sherwin-sattar/ESP32_V1.1/README.md

# ESP32 V1.1 (USB C)
## 3D views
ESP32 V1 1(1)
ESP32 V1 1(2)
