sherwin-sattar/ESP32_V1.1/Hardware/ESP32 V1.1.kicad_pcb

## KiCad design Hardware/ESP32 V1.1.kicad_pcb (2024-11-20)

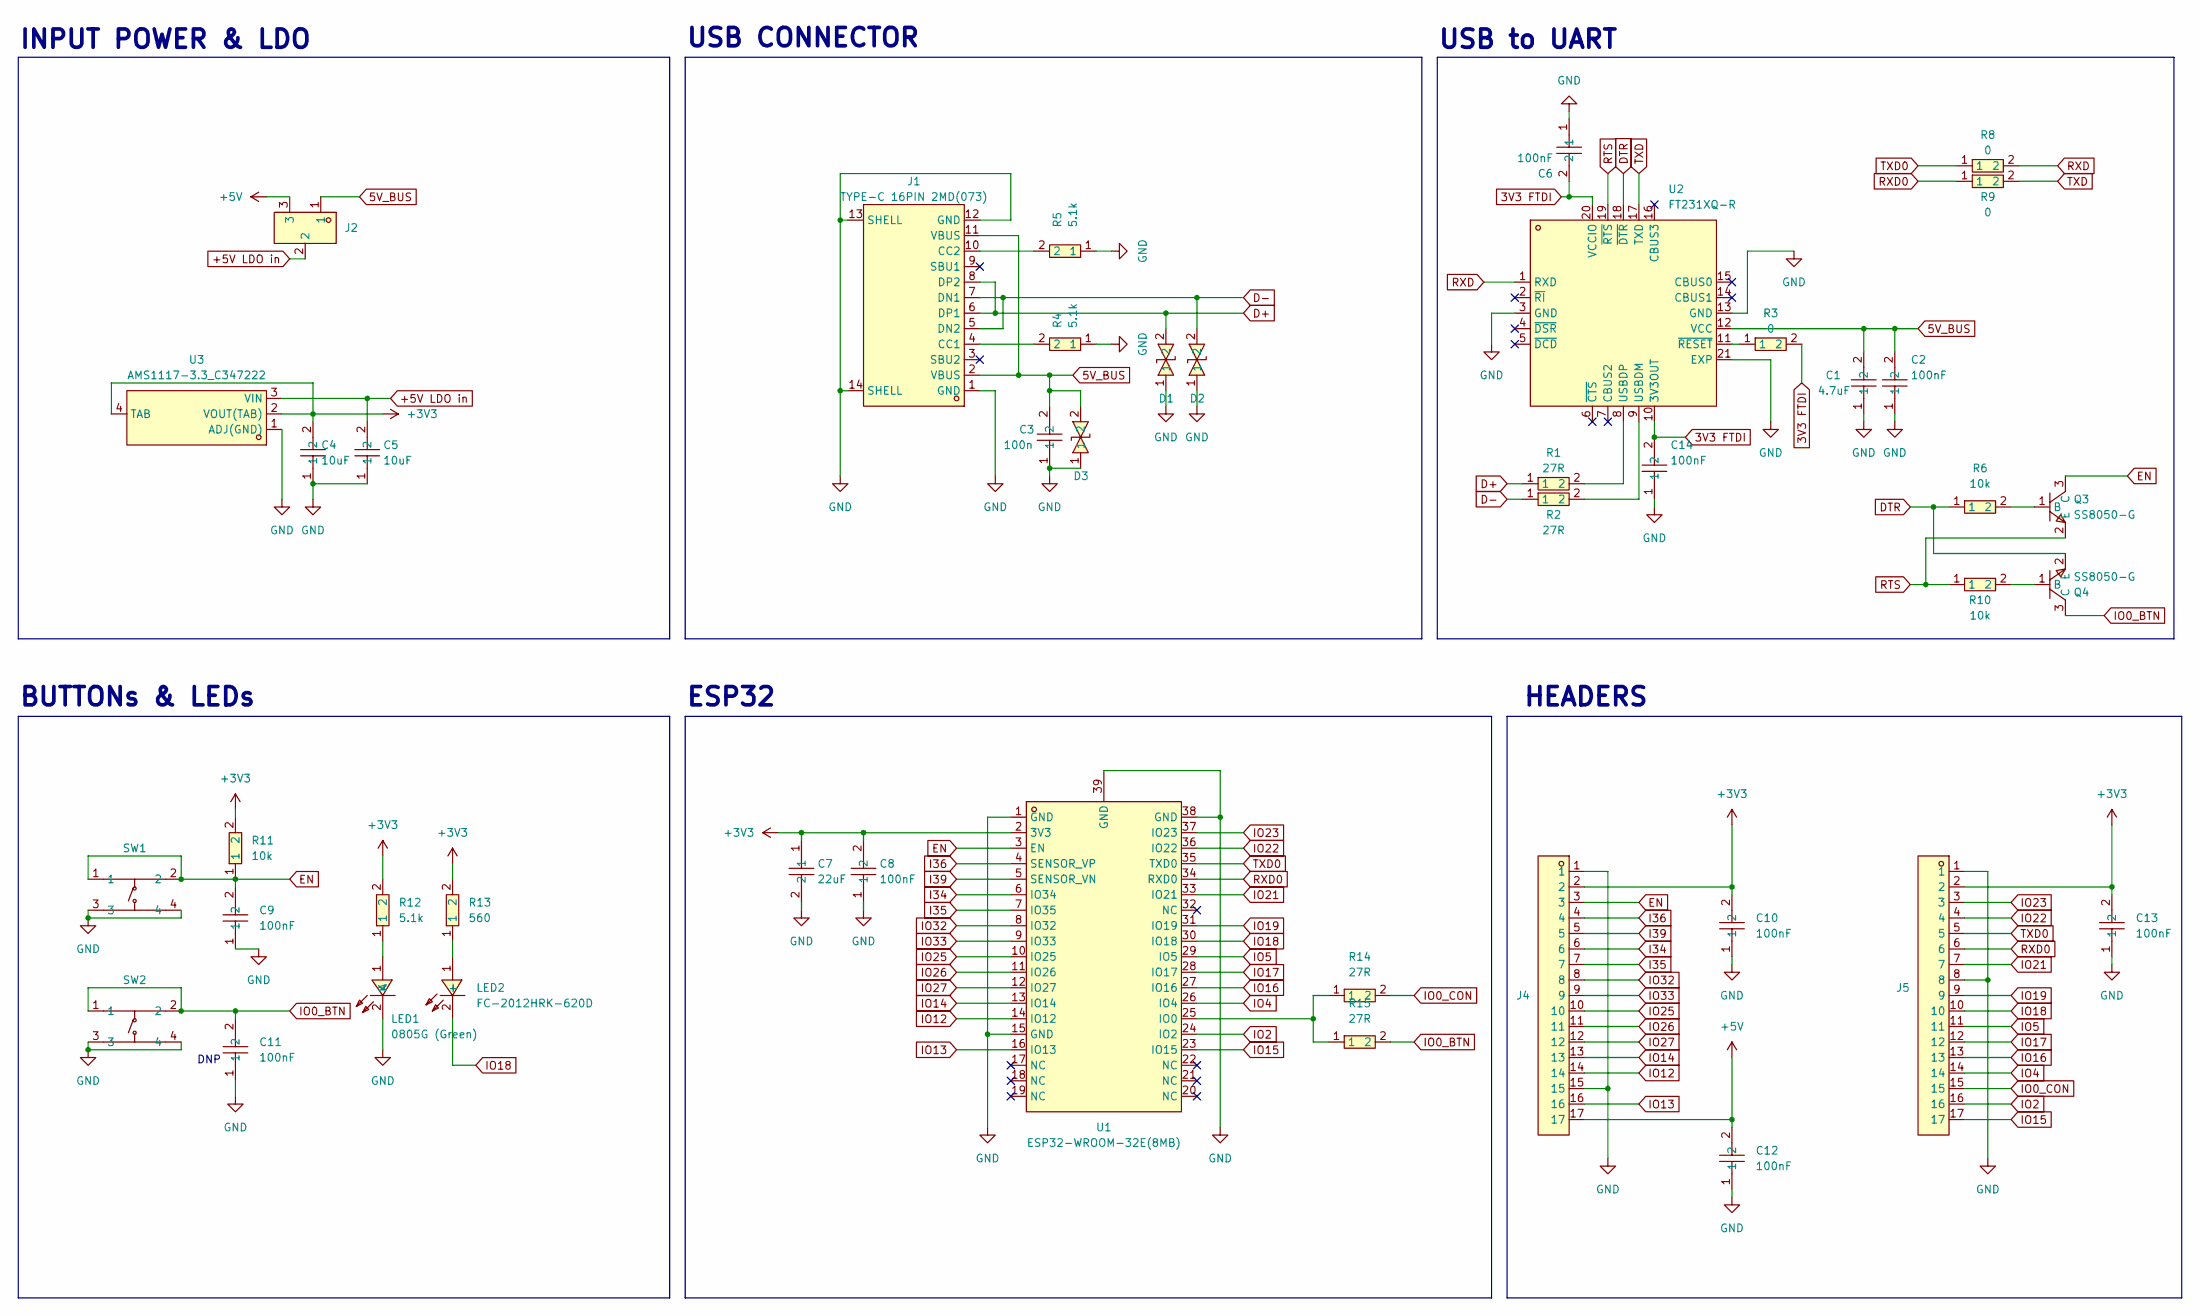
[picture p1: schematic ESP32 V1.1.kicad_sch, ESP32 V1.1]

Parts:
C1: 4.7uF; C0402; LCSC Part C368809
C2, C6, C8, C9, C10, C11, C12, C13, C14: 100nF; C0402; LCSC Part C1525
C3: 100n; C0402; LCSC Part C1525
C4, C5: 10uF; C0402; LCSC Part C315248
C7: 22uF; C0805; LCSC Part C602037
D1, D2, D3: SOD-523_L1.2-W0.8-LS1.6-BI; LCSC Part C383211
J1: TYPE-C 16PIN 2MD(073); USB-C-SMD_TYPE-C-6PIN-2MD-073; LCSC Part C2765186
J2: X1311WVS-03J-C40D42R2; HDR-SMD_3P-P1.27-V-M-LS4.2_X1311WVS-03J-C40D42R2; LCSC Part C5243526
J4, J5: X6511WV-17H-C30D60; HDR-TH_17P-P2.54-V-M; LCSC Part C725949
LED1: 0805G (Green); LED0805-R-RD; LCSC Part C2297
LED2: FC-2012HRK-620D; LED0805-R-RD; LCSC Part C84256
Q3, Q4: SS8050-G; SOT-23-3_L2.9-W1.3-P1.90-LS2.4-BR; LCSC Part C164886
R1, R2, R14, R15: 27R; R0402; LCSC Part C138021
R3, R8, R9: 0; R0402; LCSC Part C17168
R4, R5, R12: 5.1k; R0402; LCSC Part C25905
R6, R10, R11: 10k; R0402; LCSC Part C25744
R13: 560; R0402; LCSC Part C25126
SW1, SW2: PTS645SH50SMTR92LFS; KEY-SMD_4P-L6.0-W6.0-P4.50-LS9.0; LCSC Part C221869
U1: ESP32-WROOM-32E(8MB); WIFI-SMD_ESP32-WROOM-32E; LCSC Part C701342
U2: FT231XQ-R; QFN-20_L4.0-W4.0-P0.50-BL-EP2.2; LCSC Part C132159
U3: AMS1117-3.3_C347222; SOT-223-4_L6.5-W3.5-P2.30-LS7.0-BR; LCSC Part C347222

Connections:
3V3 FTDI: C6.2, C14.2, R3.2, U2.10 (3V3OUT), U2.20 (VCCIO)
5V_BUS: C1.2, C2.2, C3.2, D3.2, J1.2 (VBUS), J1.11 (VBUS), J2.1, U2.12 (VCC)
+3V3: C4.2, C7.1, C8.2, C10.2, C13.2, J4.2, J5.2, R11.2, R12.2, R13.2, U1.2 (3V3), U3.2 (VOUT(TAB)), U3.4 (TAB)
+5V: C12.2, J2.3, J4.17
+5V LDO in: C5.2, J2.2, U3.3 (VIN)
D+: D1.2, J1.6 (DP1), J1.8 (DP2), R1.1
D-: D2.2, J1.5 (DN2), J1.7 (DN1), R2.1
DTR: Q4.2 (E), R6.1, U2.18 (~DTR)
EN: C9.2, J4.3, Q3.3 (C), R11.1, SW1.1, SW1.2, U1.3 (EN)
GND: C1.1, C2.1, C3.1, C4.1, C5.1, C6.1, C7.2, C8.1, C9.1, C10.1, C11.1, C12.1, C13.1, C14.1, D1.1, D2.1, D3.1, J1.1 (GND), J1.12 (GND), J1.13 (SHELL), J1.14 (SHELL), J4.1, J4.15, J5.1, J5.8, LED1.2 (K), R4.1, R5.1, SW1.3, SW1.4, SW2.3, SW2.4, U1.1 (GND), U1.15 (GND), U1.38 (GND), U1.39 (GND), U2.3 (GND), U2.13 (GND), U2.21 (EXP), U3.1 (ADJ(GND))
I34: J4.6, U1.6 (IO34)
I35: J4.7, U1.7 (IO35)
I36: J4.4, U1.4 (SENSOR_VP)
I39: J4.5, U1.5 (SENSOR_VN)
IO0_BTN: C11.2, Q4.3 (C), R15.2, SW2.1, SW2.2
IO0_CON: J5.15, R14.2
IO2: J5.16, U1.24 (IO2)
IO4: J5.14, U1.26 (IO4)
IO5: J5.11, U1.29 (IO5)
IO12: J4.14, U1.14 (IO12)
IO13: J4.16, U1.16 (IO13)
IO14: J4.13, U1.13 (IO14)
IO15: J5.17, U1.23 (IO15)
IO16: J5.13, U1.27 (IO16)
IO17: J5.12, U1.28 (IO17)
IO18: J5.10, LED2.2 (-), U1.30 (IO18)
IO19: J5.9, U1.31 (IO19)
IO21: J5.7, U1.33 (IO21)
IO22: J5.4, U1.36 (IO22)
IO23: J5.3, U1.37 (IO23)
IO25: J4.10, U1.10 (IO25)
IO26: J4.11, U1.11 (IO26)
IO27: J4.12, U1.12 (IO27)
IO32: J4.8, U1.8 (IO32)
IO33: J4.9, U1.9 (IO33)
unnamed: J1.4 (CC1), R4.2
unnamed: J1.10 (CC2), R5.2
unnamed: LED1.1 (A), R12.1
unnamed: LED2.1 (+), R13.1
unnamed: Q3.1 (B), R6.2
unnamed: Q4.1 (B), R10.2
unnamed: R14.1, R15.1, U1.25 (IO0)
unnamed: R2.2, U2.9 (USBDM)
unnamed: R1.2, U2.8 (USBDP)
unnamed: R3.1, U2.11 (~RESET)
RTS: Q3.2 (E), R10.1, U2.19 (~RTS)
RXD: R8.2, U2.1 (RXD)
RXD0: J5.6, R9.1, U1.34 (RXD0)
TXD: R9.2, U2.17 (TXD)
TXD0: J5.5, R8.1, U1.35 (TXD0)

Notes on the sheet:
USB CONNECTOR
BUTTONs & LEDs
ESP32
INPUT POWER & LDO
HEADERS
USB to UART
DNP

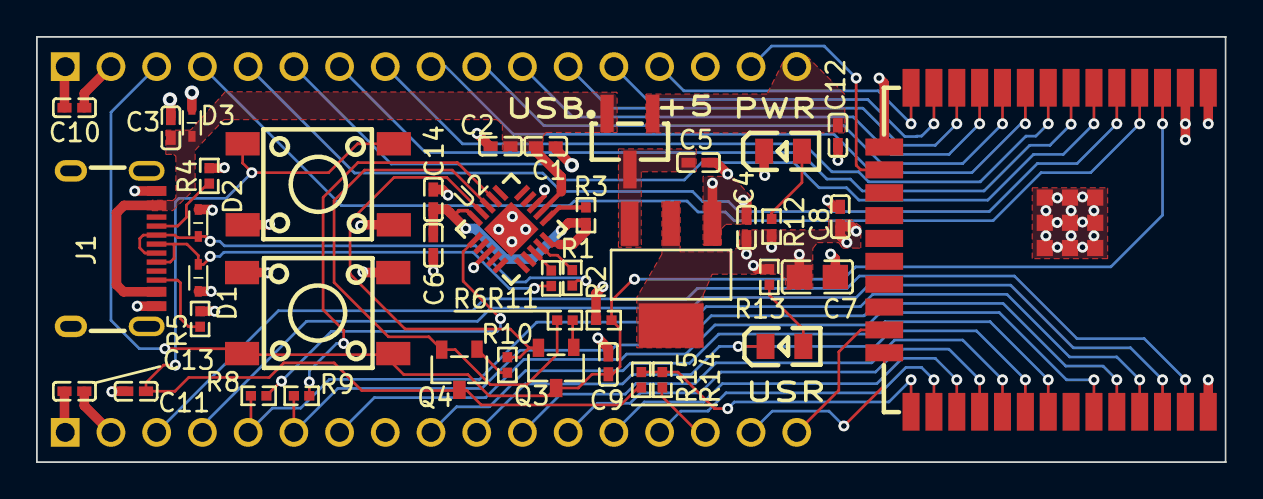
[picture p2: board ESP32 V1.1.kicad_pcb from above]

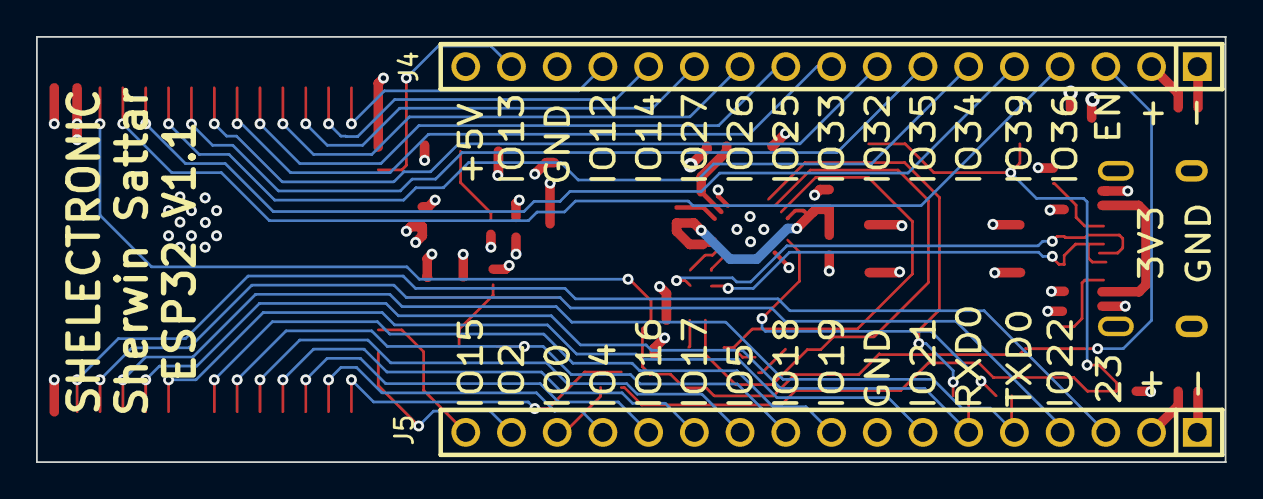
[picture p3: board ESP32 V1.1.kicad_pcb from below]

Board: 4 copper layers, 66.0 x 23.6 mm, 44 parts (2 on the bottom side), 50 nets.
